coolperson655/Zhang-Lab-Dialysis-Pump/PCB_back.jpeg

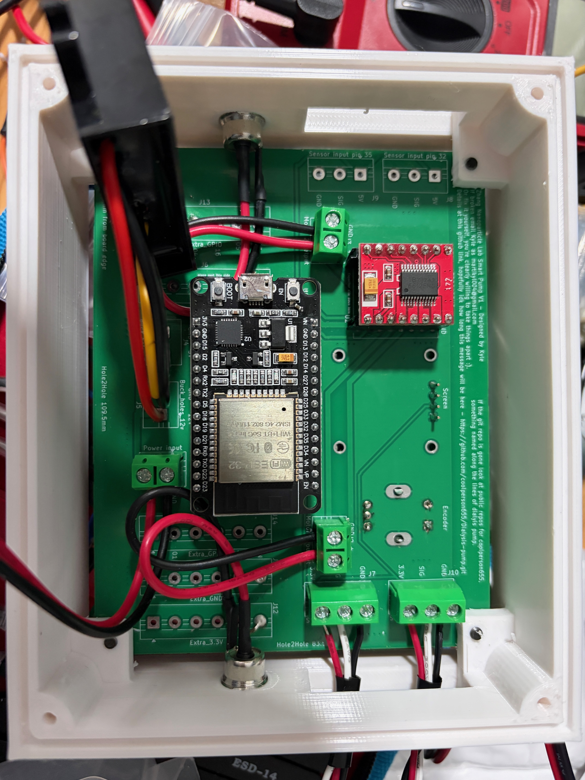
PCB_back.jpeg
