coolperson655/Zhang-Lab-Dialysis-Pump/PCB_front.jpeg

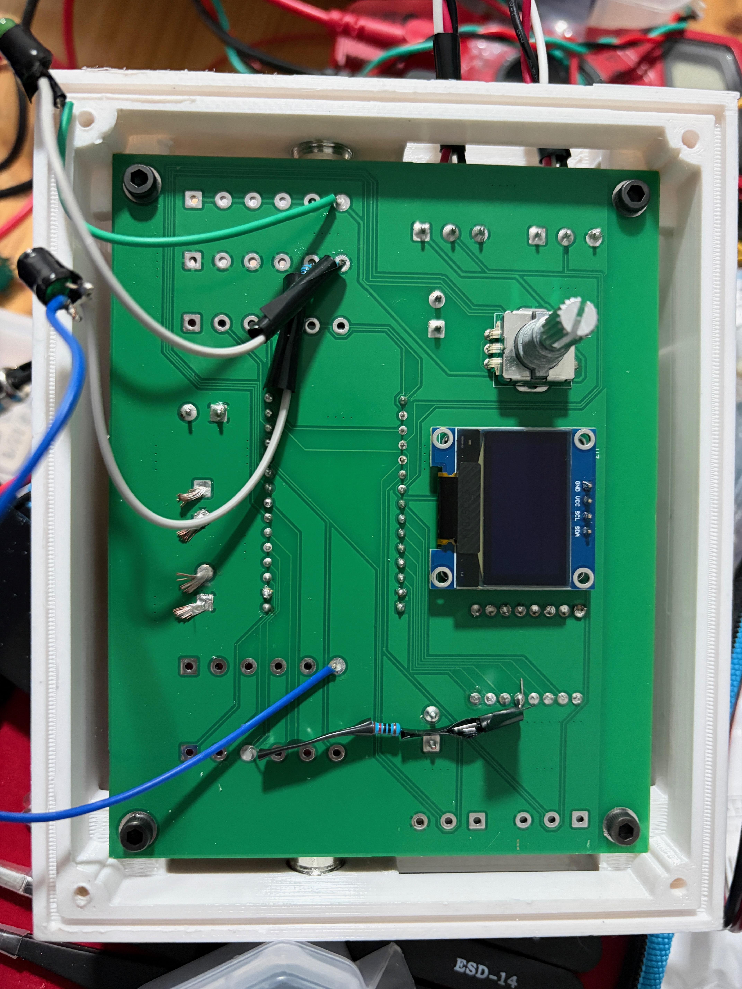
PCB_front.jpeg
