coolperson655/Zhang-Lab-Dialysis-Pump/Case_and_motors.jpeg

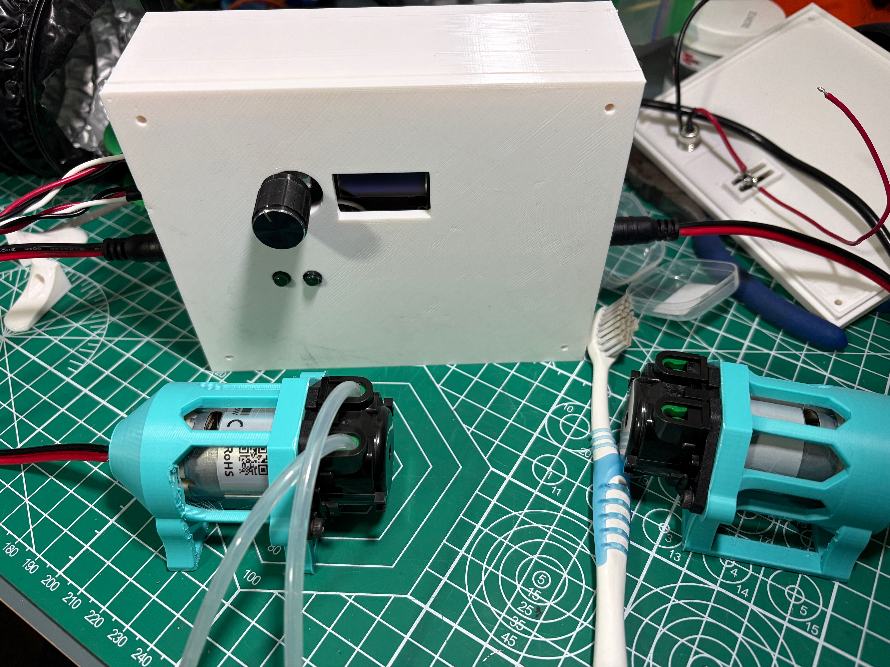
Case_and_motors.jpeg
