coolperson655/Zhang-Lab-Dialysis-Pump/Dialysis pump BOM-2.pdf

Part | Count | Unit price Total | Link
Pump | 2 | 10 | 20 https://www.amazon.com/dp/B092Z9HR3D/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
Microcontroller | 1 | 17 | 17 https://www.amazon.com/dp/B08D5ZD528/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

# 12V power

supply | 1 | 14 | 14 ht t ps: / / www. am az on. com / ALITOVE- Adapt er - Conver t er - 100- 240V- 5- 5x2- 1m m / dp/ B01GEA8PQA/ r ef =sr _1_4?cr id=2HUEGUH6IUN4Y&dib=eyJ 2IjoiMSJ 9. UhHhKO1vPz LCj7r 6s8RyVjbcm RqUuFqJ NMEnHz OsDI8c7n0YXhb1DBUJ XXb6m W XgW ITuuz RsVcRM7RqA- kykMVFypGt yI285iPcQ8KTg9W PZQR86_D9r 8Kh_cATeF2yPQguz r QHueQ_lwwjaypM55m Bf iW YIe_eoyf Ugi- KXjy1SNW oKyM5S9UFd4iQNsRZf 3TNqDGM73iaNSf oTr RvISj5Df 5q6OPf sC9vit qJ luYM. G9W 45jG4R8ct m dt ePoRALr 2f cpHvXJ eCRMQlO3ALq48&dib_t ag=se&keywor ds=12v% 2Bpower % 2Bsupply&qid=1782022492&spr (https://www.amazon.com/ALITOVE-Adapter-Converter-100-240V-5-5x2-1mm/dp/B01GEA8PQA) ef ix=12v% 2Bpower % 2B% 2Caps% 2C260&sr =8- 4&t h=1
BPT tubing | 2 | 0 | 0 ht t ps: / / www. am az on. com / Silcone- Per ist alt ic- AcidAlkali- Labor at or y- Ext r usion/ dp/ B0CFDNJ 56Z/ r ef =sr _1_3?cr id=8KQ3QOYPDKD6&dib=eyJ 2IjoiMSJ 9. 926m Tu_lwAUaZt wej4J dn6kO6z m LkhL_Mi_2X9wlFLm CeGhxf HGf AAlMZjSDikjsSkr P6CACl8yi9lv2V_37d2qr nILYKkChkaFy2Ke7- QNSgz W 6f iKhf wnt nEo1Bm eEf Dr ua6P2- t vW Kv4ZuW I3Rk0r N_IY7dgEbZsBiAEQJ 99ECKeFCqt 4wgRCEm F5W D06Y4Yj72Q7RBz sUNgTiKoIOwTigTH9DP2iPr E2G1Fu1E. FZ1ZZKBz dXsoyux8oqp0kv2GTNq05eAEe1dd3QSPBlY&dib_t ag=se&keywor ds=bpt +t ubing&qid=1782021187&spr ef ix=bpt +t ubin% 2Caps% (https://www.amazon.com/Silicone-Peristaltic-AcidAlkali-Laboratory-Extrusion/dp/B0CFDNJ56Z) 2C229&sr =8- 3
Silicone tubing | 1 | 9 | 9 ht t ps: / / www. am az on. com / Hooshing- Silcone- Flexible- W inem aking- Tr ansf er / dp/ B08PTXMNCN/ r ef =sr _1_6?dib=eyJ 2IjoiMSJ 9. K1BDm NxxENMkgJ m wqNaxvXHSz bxf QALr ONS6i- m t Npnl- o7IeZ84G5nH68DQvgkiNUIYNJ z Ovut boI_nxQXXSbDnAjEz D5S5wjm wqDwFT8t 8nagXRFMj46w_yz CCHOF_FxgwNFlz RxhSuvkr V47Lv3eyjVcqVCIV8LqDDeIez GDNsFHdt oXt VnC7O45ui3bjm yspt f IlOOS1Paf Q2pLuDypksp- vm GoYagt 0SywqSE. Uf eUApxr YyooOYVeYg66NiVuhdReUs4HBZz U- COThqs&dib_t ag=se&keywor ds=2x4m m % 2Bdialysis% 2Bt ubing&qid=1782414220&sr =8- 6&t h=1 (https://www.amazon.com/Hooshing-Silicone-Flexible-Winemaking-Transfer/dp/B08PTXMNCN)
Screen | 1 | 10 | 10 ht t ps: / / www. am az on. com / ELEGOO- Display- Com pact - Self - Lum inous- Pr oject s/ dp/ B0D2RMQQHR/ r ef =sr _1_4?cr id=2ISZW D58OSVLN&dib=eyJ 2IjoiMSJ 9. 58hVCpHB84ehQZ- yEi0om QI1h5VIOYsONAr 2V3af Ep4xS_CHVRZGa3agxIDPLMK7cFp_SW HxQ_PoBdXyJ KBXz gopOqAj- A8dihXyiC6xsz M1DUm gddCjUcyr jd5aubhAnCJ 468t t GqnGy6gFZLhjAdsd3Ds_aB_MI8uKFTr 4F2lY_TPMZinVAs- bxkg69B4gm YIbsMo570KJ f No3qLK- bNl1i602LohAz bgXUGW u3J s. pyK_HqFz 8_vbhQenVQXkGb3t qt T0dkiUSY2LiFSbt QU&dib_t ag=se&keywor ds=esp32% 2Bscr een&qid=1782021874&spr ef ix=esp32% (https://www.amazon.com/ELEGOO-Display-Compact-Self-Luminous-Projects/dp/B0D2RMQQHR) 2Bscr een% 2Caps% 2C240&sr =8- 4&t h=1
Level sensor | 2 | 20 | 40 ht t ps: / / www. am az on. com / CQRobot - Capacit ive- Non- Cont act - Mot her boar ds- Agr icult ur e/ dp/ B0FL22MJ KX/ r ef =sr _1_3?cr id=27MQZGOHE24Z4&dib=eyJ 2IjoiMSJ 9. 7bf 2G2aVm K8- NSQM71pg3dqIMug1Q9Axf NB8UlMcibJ 6t iZAOP5m z bIeFx6eL3uxXslC02ekqPQf P2- Kk- koyr kQAnN- sad3TI5ckSBjkAxAoPKz t sIL8ECjKlC31KpXjA9aJ z _DAT05PvvY45Sc_Tt f BQD52juS5RVG7MgvnAHExSIJ RZ1C- XDQOhUjve1SZZt Ree9nlH_iAbDuZ4Vjc4z NBOSN7t jC- DQYVkgZAAE. pEhnsW m f oZEMFIt eP20OlEGTMquLjcnFEyqEt le6xMs&dib_t ag=se&keywor ds=capacit ive% 2Bliquid% 2Bsensor &qid=1782022079&spr (https://www.amazon.com/CQRobot-Capacitive-Non-Contact-Motherboards-Agriculture/dp/B0FL22MJKX) ef ix=capacit ive% 2Bliwuid% 2Bsens% 2Caps% 2C253&sr =8- 3&t h=1
Motor controller | 1 | 8 | 8 (https://www.amazon.com/DIANN-TB6612FNG-Stepper-Driver-Module/dp/B0BLRSWTLM?adgrpid=1343603779665372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)

# Buck converter

12->5 | 1 | 6 | 6
Control knobs | 1 | 10 | 10 (https://www.amazon.com/Cylewet-Encoder-Digital-Potentiometer-Arduino/dp/B07DM2YMT4)
PCB | 1 | 30 | 30
PETG | 1 | 15 | 15

Links or notes Socket Headers (https://www.amazon.com/dp/B0CZ6X313F?ref=ppx_yo2ov_dt_b_fed_asin_title) Screw set (https://www.amazon.com/dp/B0FJFVG31G?ref=ppx_yo2ov_dt_b_fed_asin_title) Power sockets (https://www.amazon.com/dp/B08LQ3SB3F?ref=ppx_yo2ov_dt_b_fed_asin_title) Screw terminals (https://www.amazon.com/dp/B0D1GMMTZ5?ref=ppx_yo2ov_dt_b_fed_asin_title) Assorted resistorsAny general electronics kit

22 AWG wire (https://www.amazon.com/Fermerry-Stranded-Electric-Tinned-Copper/dp/B089CQHRDT?sp_csd=d2lkZ2V0TmFtZT1zcF9hdGY)

# Some components are multipacks

# 12V barrel jack

# ESP 32 dev kit 1

# These are general electronics these are just the link I used since I wanted extra parts for other projects

# Many suppliers

# Includes cost for more than one device. Some components like microcontroller and motor controllers dont come in 1 packs(at least not at good prices)

# Chose one of these

# This is the cost of a minimum order(5) for JLCpcb

LEDs | Any general electronics kit
