coolperson655/Zhang-Lab-Dialysis-Pump/Sensor board cover.stl

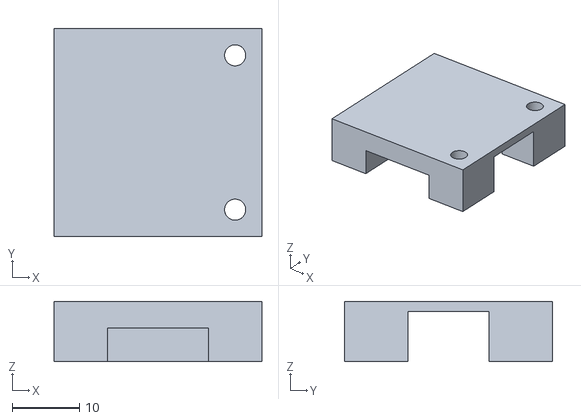
[picture p4: CAD file, 2026-10-11]
Sensor board cover.stl
31.0 x 31.0 x 9.00
