coolperson655/Zhang-Lab-Dialysis-Pump/Motor holder final.stl

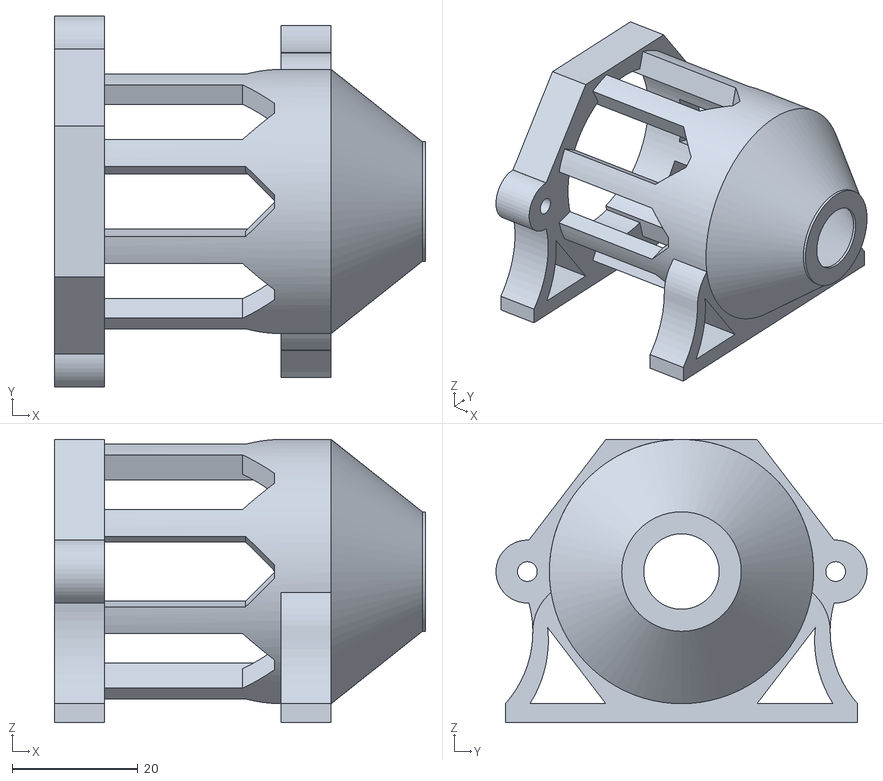
[picture p5: CAD file, 2026-10-02]
Motor holder final.stl
59.0 x 59.0 x 45.0
