coolperson655/Zhang-Lab-Dialysis-Pump/V2 case front.stl

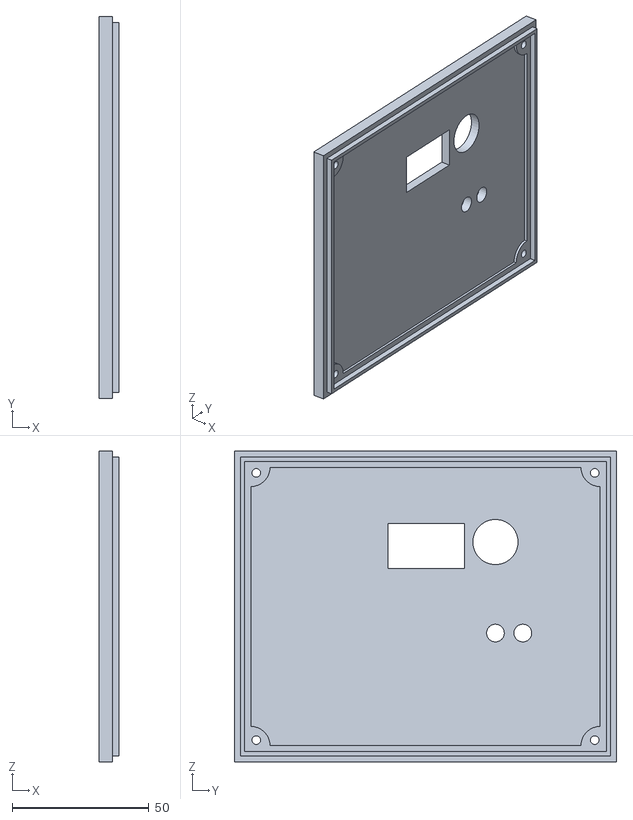
[picture p6: CAD file, 2026-10-02]
V2 case front.stl
7.40 x 139.6 x 113.6
