coolperson655/Zhang-Lab-Dialysis-Pump/Case Stabilizer.stl

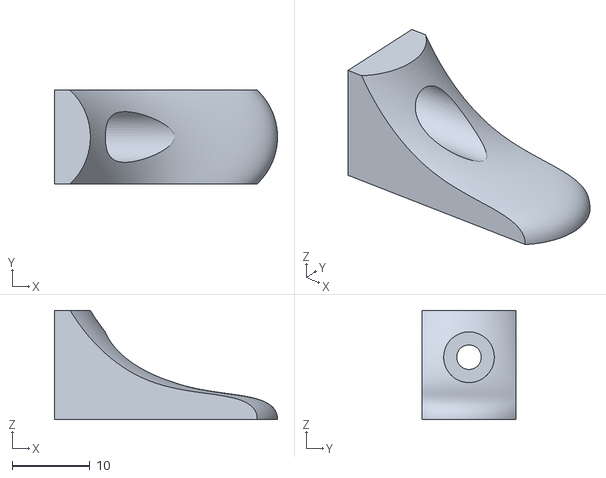
[picture p7: CAD file, 2026-10-02]
Case Stabilizer.stl
28.6 x 12.0 x 14.0
