coolperson655/Zhang-Lab-Dialysis-Pump/V2 pump case middle- holes and fit fixed.stl

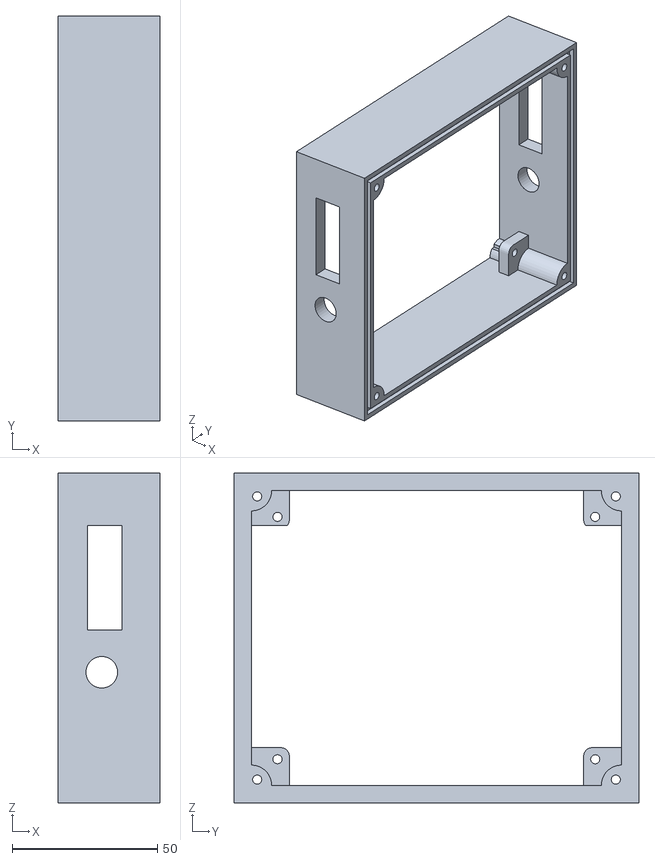
[picture p8: CAD file, 2026-10-02]
V2 pump case middle- holes and fit fixed.stl
35.0 x 139.6 x 113.6
