coolperson655/Zhang-Lab-Dialysis-Pump/V2 case back fixed.stl

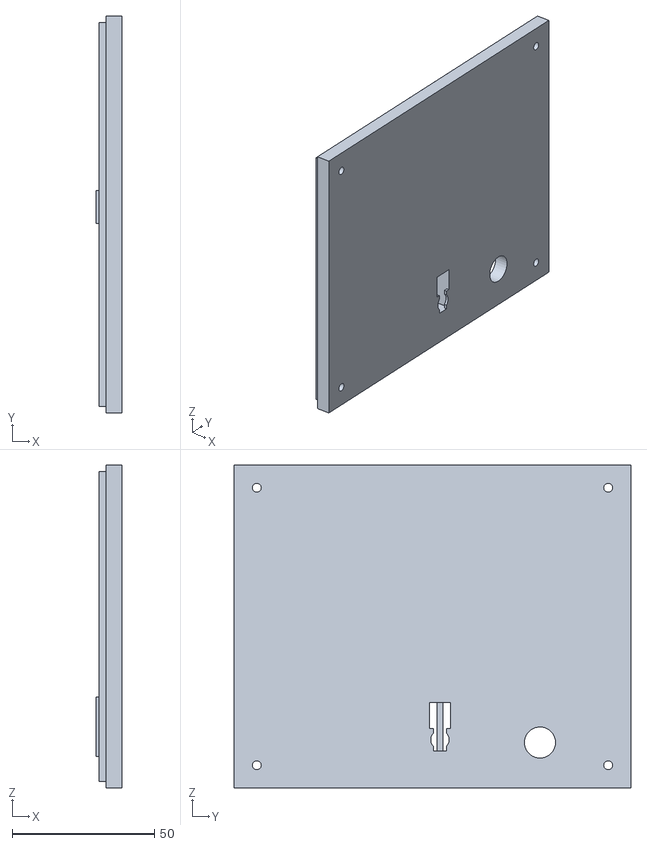
[picture p9: CAD file, 2026-10-02]
V2 case back fixed.stl
9.00 x 139.6 x 113.6
