coolperson655/Zhang-Lab-Dialysis-Pump/src/two_sesnors.ino

// This file intentionally left blank.
// A stray top-level statement in a previous draft caused PlatformIO to fail
// compilation, so this placeholder keeps the project buildable while the
// main firmware continues to live in TB6612FNG_version.ino.
